NationalAssociationOfRealtors/IndoorAirQualitySensor/_T1.jpg

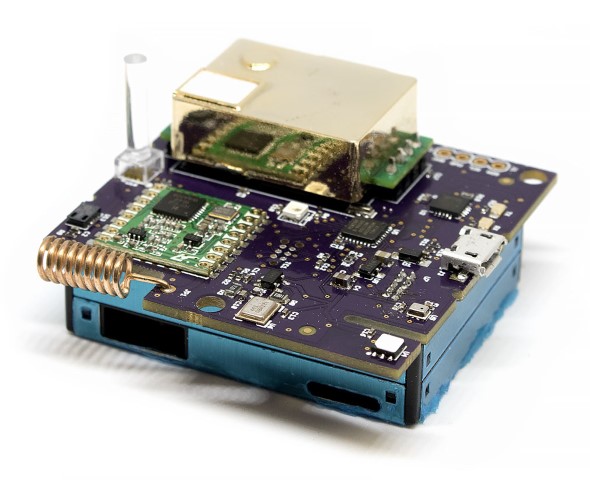
_T1.jpg
