NationalAssociationOfRealtors/IndoorAirQualitySensor/README.md

All development on the Indoor Air Quality sensor is now on its own repository [here](https://github.com/NationalAssociationOfRealtors/Touchstone).

This repo is left for historical records only.
