NationalAssociationOfRealtors/IndoorAirQualitySensor/_OSHPark_render_v056b.png

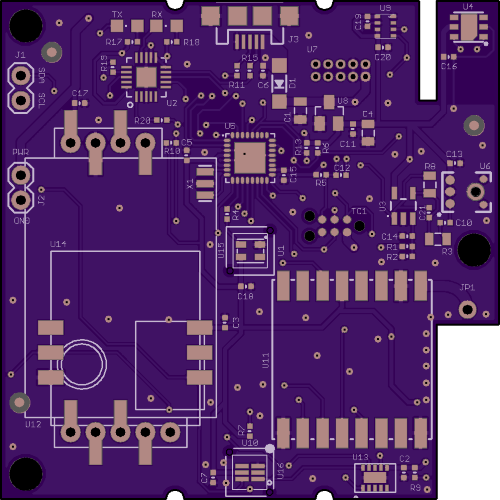
_OSHPark_render_v056b.png
