NationalAssociationOfRealtors/IndoorAirQualitySensor/enclosure/IAQ-Case-bottom.stl

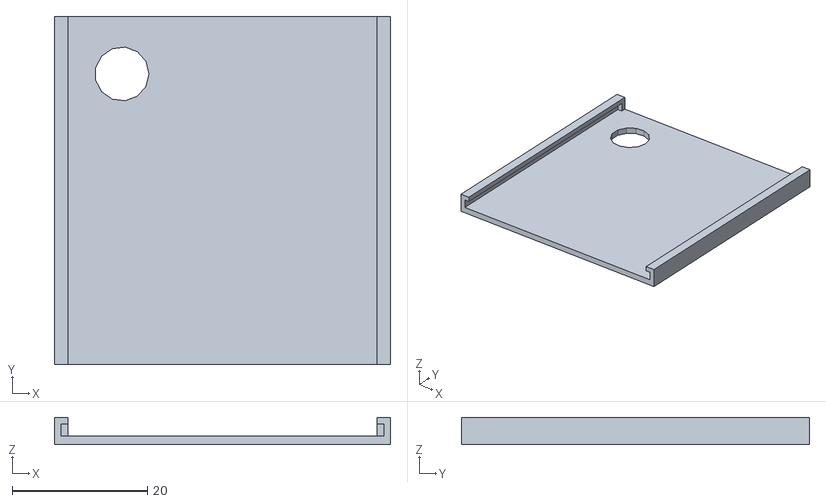
[picture p3: CAD file, 2016-09-28]
enclosure/IAQ-Case-bottom.stl
49.8 x 51.5 x 4.00
