NationalAssociationOfRealtors/IndoorAirQualitySensor/enclosure/includes/IAQ-Case.stl

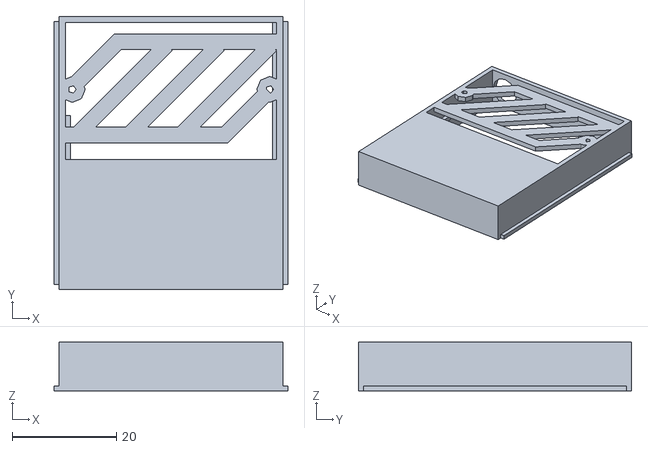
[picture p4: CAD file, 2016-09-28]
enclosure/includes/IAQ-Case.stl
44.9 x 52.4 x 9.40
