NationalAssociationOfRealtors/IndoorAirQualitySensor/enclosure/includes/IAQ-Case-bottom.stl

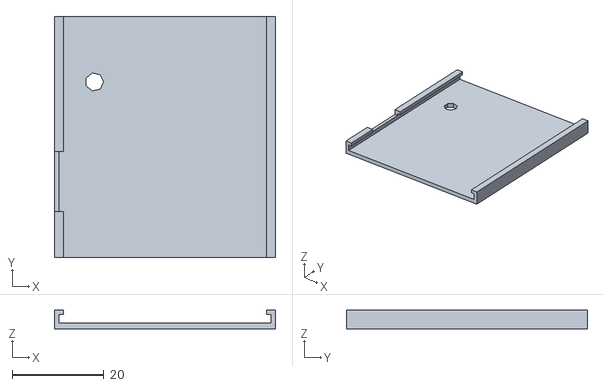
[picture p5: CAD file, 2016-09-28]
enclosure/includes/IAQ-Case-bottom.stl
48.1 x 52.4 x 4.10
