NationalAssociationOfRealtors/IndoorAirQualitySensor/IAQ-Case.scad

// IAQ Cover and Base v.0.01
// August 2016
// Initial Design to Protect Sensor Board IAQ Circuit Board Designed by Akram Ali
// CRT Labs / National Association of REALTORS
// https://crtlabs.org

////////////////////////////////////////////////
// Includes and Definitions
////////////////////////////////////////////////
use <Write.scad>
use <honeycomb.scad>
use <sensorlocations.scad>
top_cover_height = 3;
base_width = 47.5;
base_length = 40.5;
case_shell = 2;
spacer = 10;
font = "orbitron.dxf";

////////////////////////////////////////////////
// Honeycomb Settings
////////////////////////////////////////////////
// number of rows and columns, beware that some hexagonal cells are clipped
// at rectangular box boundaries, so the total number of cells will be
// smaller than rows * columns
rows          = 12;
columns       = 9;

// cell step is hole size between opposite hexagon walls plus inner wall thickness
cell_step     = 4.87;

// inner depth of the hexagonal boxes
hex_height        = 3;

// walls thickness
inner_walls   = .51;
outer_walls   = 2.65;

// this clearance should allow fitting of the lid over the bottom box
lid_clearance = 0.6;

// how far does the lid protrube inside the bottom box
lid_depth     = 5;

////////////////////////////////////////////////
// Modules 
/////////////////////////////////////////////////
module top_cover() {
  difference() {
      cube([base_length + 2 * case_shell, base_width + 2 * case_shell, top_cover_height + 2 * case_shell]);
      translate([case_shell, case_shell, 0])
        cube([base_length, base_width, top_cover_height + 2 *case_shell]);
   }
}

module bottom_cover() {
  translate([0, base_width + spacer, 0]) {
    difference() {
      cube([base_length + 2 * case_shell, base_width + 2 * case_shell, top_cover_height + 2 * case_shell]);
      translate([case_shell, case_shell, case_shell])
        cube([base_length, base_width, top_cover_height + case_shell]);
    }
  }
}


module cutouts(){
        microphone(); 
        reset_button();
        pin_outs();
        co_no2();
        light_intensity();
        pressure();
        temp_humid();
}
module add_text(){
  translate ([base_width +case_shell-7, case_shell, top_cover_height+2*case_shell])
    rotate([0,0,90])
      write("CRT Labs IAQ", font = font , h = 2);


  translate ([base_width +case_shell-7, base_length-10, top_cover_height + 2*case_shell])
   rotate([0,0,90])
     write("https://crtlabs.org", font = font, h = 1.5);
     
}

module main(){
    translate ([0,0,top_cover_height + 2* case_shell])
       rotate([180,0,0]){
            top_cover();
            translate([0,0, top_cover_height + case_shell])
            bottom_part(rows, columns, cell_step, inner_walls, outer_walls, hex_height);
       }
      
       translate([0,spacer,0]){
           bottom_part(rows, columns, cell_step, inner_walls, outer_walls, hex_height);
       }
}

main();
