NationalAssociationOfRealtors/IndoorAirQualitySensor/(list of files, cad)

Other CAD files:
enclosure/includes/case.dxf
