NationalAssociationOfRealtors/IndoorAirQualitySensor/(threads)

Thread 2 (2017-03-08):

IAQ Core sensor reading fails

Korcsog, 2017-03-08:
Hi!
I've got an IAQ core C sensor as in that project.
I'm using the same code as you in my project, but i could not read any values from the MEMS sensor, except FF values or B5 values. The wiring and the resistors are OK. I'm using an ESP8266 (Wemos D1 mini) as an MCU. Any idea?

Is the CCS811 sensor better than the IAQ Core?

AKstudios, 2017-03-13:
They have similar performance. How did you solder the IAQ core? It's not great with reflows.
Can't tell much without looking at the code, setup, etc.

Korcsog, 2017-03-24:
Hi!
Simply soldered some wires temporarily.
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

Here is the code which doesn't work:
```
#include "Wire.h"

#define iaqaddress 0x5A

uint16_t predict;
uint8_t statu;
int32_t resistance;
uint16_t tvoc;

void setup()
{
  Serial.begin(9600);
  Wire.begin();
}

void loop()
{
  readAllBytes();
  checkStatus();

  Serial.print("CO2:");
  Serial.print(predict);
  Serial.print(", Status:");
  Serial.print(statu, HEX);
  Serial.print(", Resistance:");
  Serial.print(resistance);
  Serial.print(", TVoC:");
  Serial.println(tvoc);

  delay(2000);

}
void readAllBytes()
{
  Wire.requestFrom(iaqaddress, 9);

  predict = (Wire.read()<< 8 | Wire.read());
  statu = Wire.read();
  resistance = (Wire.read()& 0x00)| (Wire.read()<<16)| (Wire.read()<<8| Wire.read());
  tvoc = (Wire.read()<<8 | Wire.read());
}
void checkStatus()
{
  if(statu == 0x10)
  {
    Serial.println("Warming up...");
  }
  else if(statu == 0x00)
  {
    Serial.println("Ready");
  }
  else if(statu == 0x01)
  {
    Serial.println("Busy");
  }
  else if(statu == 0x80)
  {
    Serial.println("Error");
  }
  else
  Serial.println("No Status, check module");
}

```
I'm totally re-wrote from scratch (using an i2c library) and works:

```
 #include "brzo_i2c.h"

uint8_t SDA_PIN = 4;
uint8_t SCL_PIN = 5;
uint8_t iaq_adr = 0x5A;

uint8_t buffer[10];

uint8_t error = 0;

uint16_t co2;
uint16_t tvoc;

void setup() {
  Serial.begin(115200);
  brzo_i2c_setup(SDA_PIN, SCL_PIN, 3000);
}

void loop() {
   brzo_i2c_start_transaction(iaq_adr, 100);
   brzo_i2c_read(buffer, 9, true);

   if (buffer[2] == 0x10 ){
       Serial.println("Warming up...");
   } else
   {

    co2 = buffer[0] * pow(2, 8) + buffer[1];
    tvoc = buffer[7] * pow(2, 8) + buffer[8];

    Serial.print("CO2 : \t"); Serial.print(co2);
    Serial.print("TVOC : \t"); Serial.println(tvoc);
   }

   /*
   Serial.print("Byte 1:\t"); Serial.println(buffer[0]);
   Serial.print("Byte 2:\t"); Serial.println(buffer[1]);
   Serial.print("Byte 3 (status) :\t"); Serial.println(buffer[2]);
   Serial.print("Byte 4:\t"); Serial.println(buffer[3]);
   Serial.print("Byte 5:\t"); Serial.println(buffer[4]);
   Serial.print("Byte 6:\t"); Serial.println(buffer[5]);
   Serial.print("Byte 7:\t"); Serial.println(buffer[6]);
   Serial.print("Byte 8:\t"); Serial.println(buffer[7]);
   Serial.print("Byte 9:\t"); Serial.println(buffer[7]);
   */

   error = brzo_i2c_end_transaction();

   if (error == 0) {
     //Serial.println("No i2c communication errors");
  }
  else {
    Serial.print("Brzo error : ");
    Serial.println(error);
  }
   delay(500);
}
```

Closed 2017-03-24.
