NationalAssociationOfRealtors/IndoorAirQualitySensor/hardware/v0.56/sensor_board_v0.56.brd

## EAGLE design hardware/v0.56/sensor_board_v0.56.brd (2017-07-17)

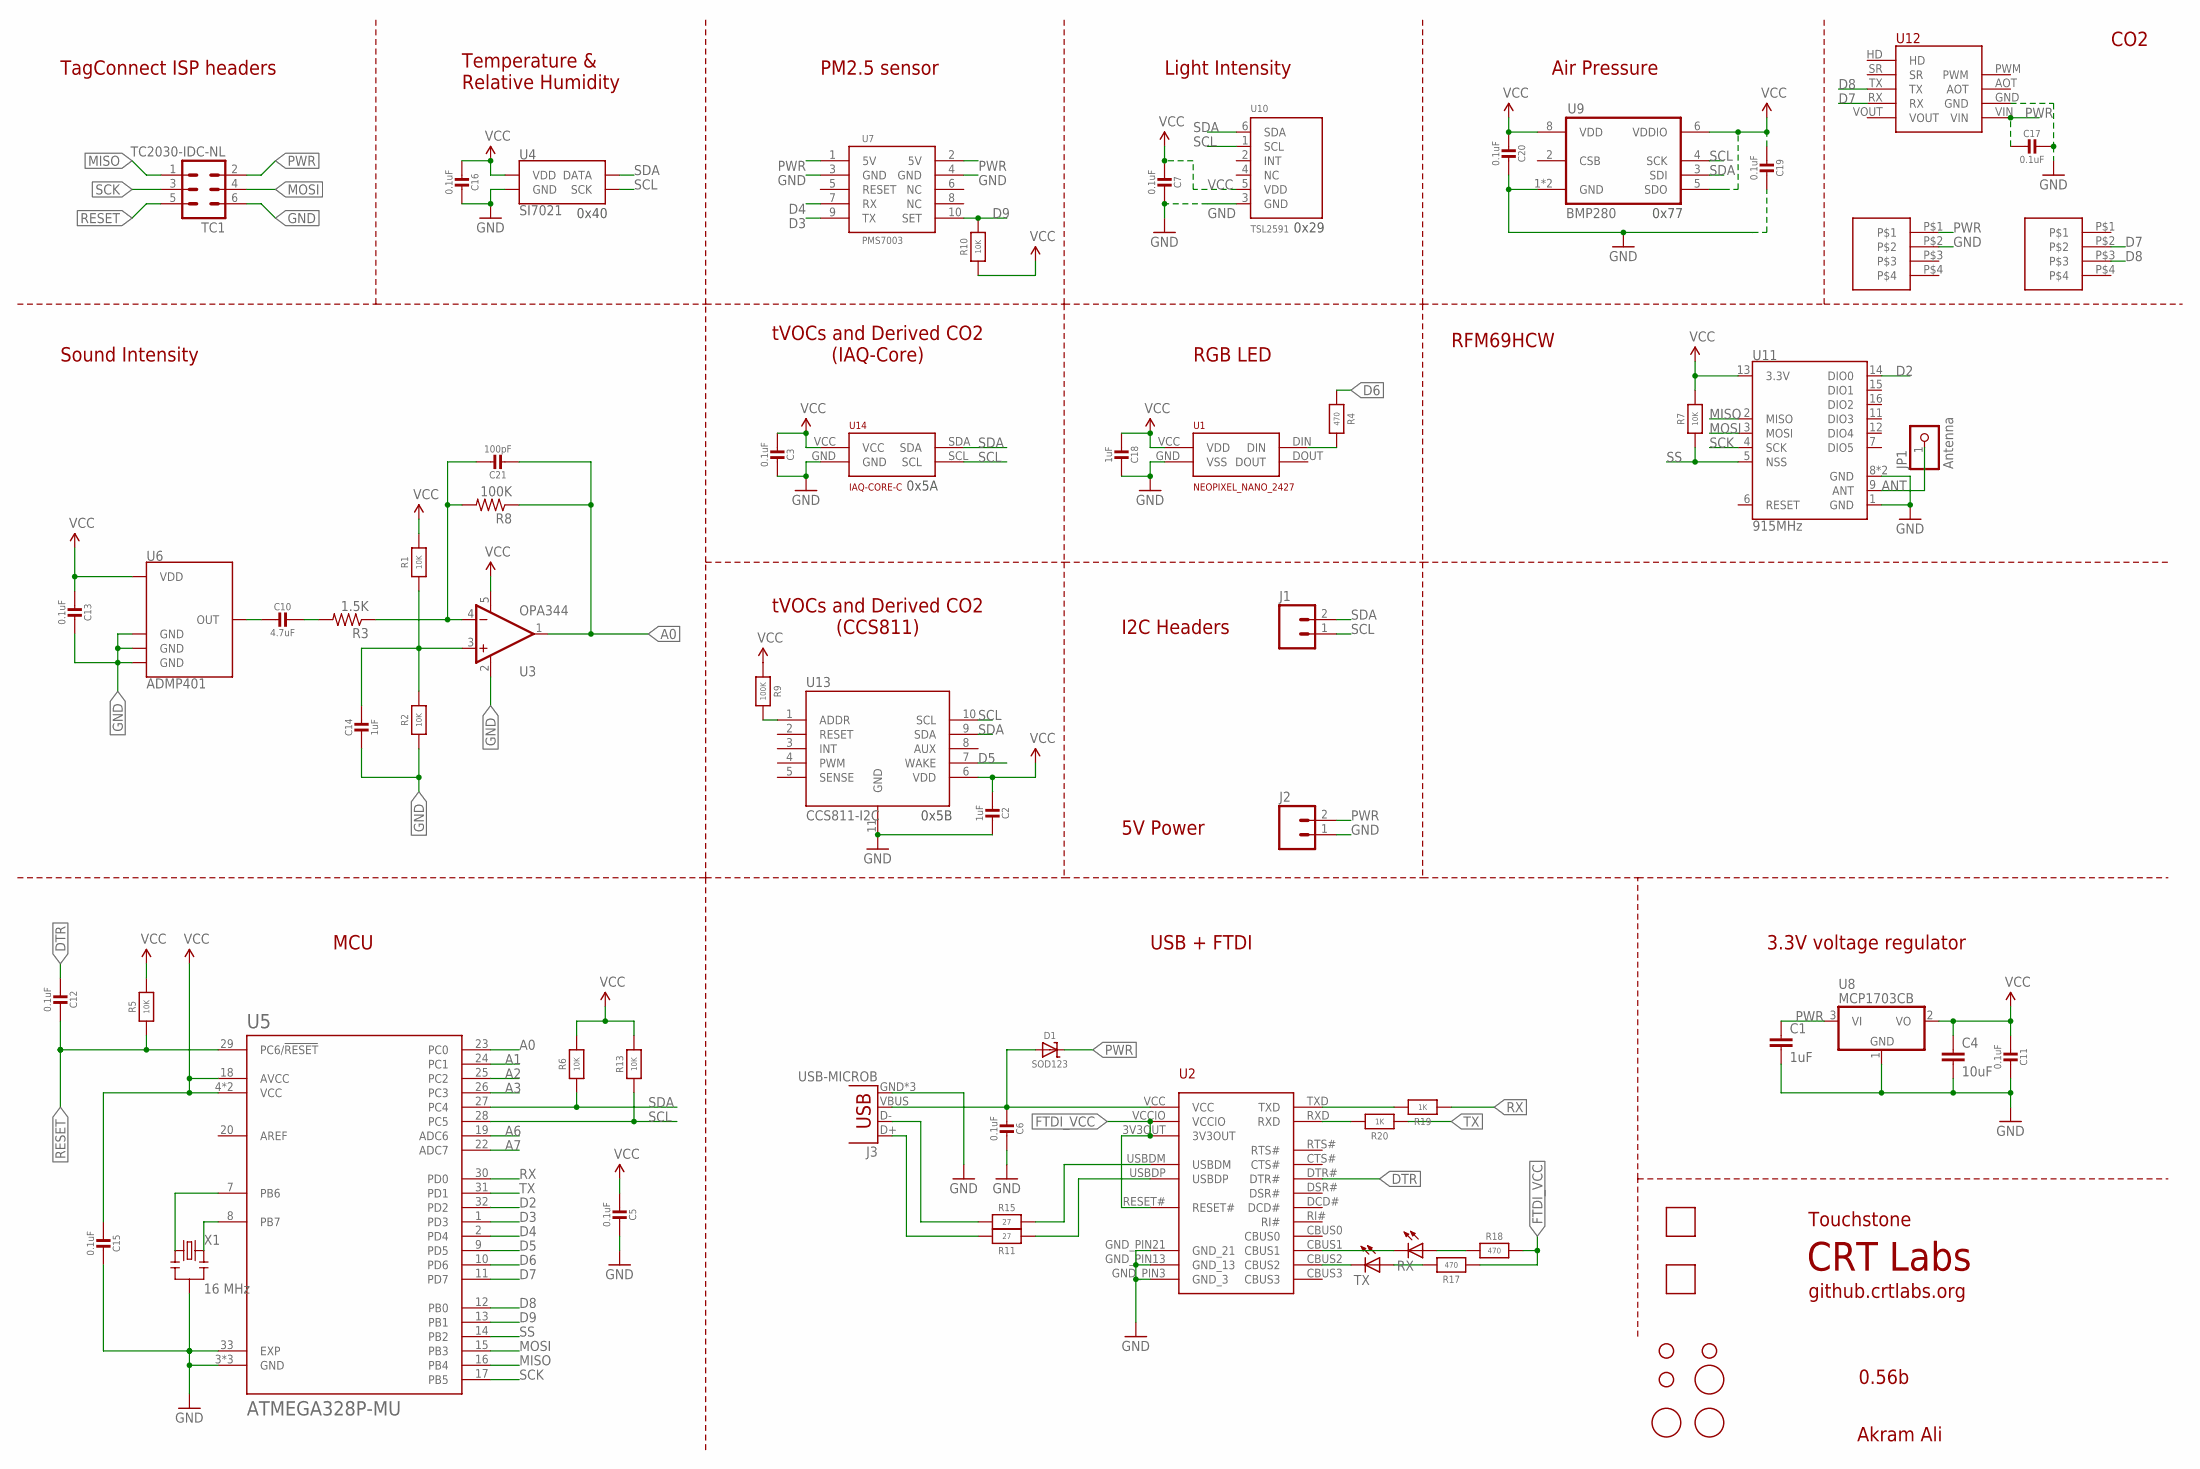
[picture p6: schematic sensor_board_v0.56.sch]

Parts:
C1: 1uF; 0805; MPN CC0805ZRY5V8BB105
C2, C14, C18: 1uF; MICROBUILDER__0402MP
C3, C5, C6, C7, C11, C12, C13, C15, C16, C17, C19, C20: 0.1uF; MICROBUILDER__0402MP
C4: 10uF; 0805; MPN CC0805KKX5R6BB106
C10: 4.7uF; MICROBUILDER__0402MP
C21: 100pF; MICROBUILDER__0402MP
D1: SOD123; MICROBUILDER_SOD-123
H1, H2, H3: STAND-OFF
J1, J2: M02PTH; 1X02
J3: USB-MICROB; MPN 47346-0001
JP1: Antenna; 1X01-CLEANBIG
R1, R2, R5, R6, R7, R10, R13: 10K; MICROBUILDER__0402MP
R3: 1.5K; 0805; MPN RC0805FR-071K5L
R4, R17, R18: 470; MICROBUILDER__0402MP
R8: 100K; 0805; MPN RC0805FR-07100KL
R9: 100K; MICROBUILDER__0402MP
R11, R15: 27; MICROBUILDER__0402MP
R19, R20: 1K; MICROBUILDER__0402MP
RX: LEDCHIPLED_0805; CHIPLED_0805; MPN LG R971-KN-1
TC1: TC2030-IDC-NL
TX: LEDCHIPLED_0805; CHIPLED_0805; MPN LG R971-KN-1
U1: NEOPIXEL_NANO_2427; SK6805-2427
U2: FT231XQ-R; FTDI_FT231XQ-R_PACKAGE
U3: OPA344; SOT23-5; MPN OPA344NA/3K
U4: SI7021; DFN-6-3X3-SI7021
U5: ATMEGA328P-MU; QFN50P500X500X100-33N
U6: ADMP401; MPN INMP401ACEZ-R7
U7: PMS7003; PMS7003_RECEPTACLE_1.27MM_2X5
U8: MCP1703CB; SOT23; MPN MCP1703T-2502E/CB
U9: BMP280; MPN BMP280
U10: TSL2591; DFN6_TAOS; MPN TSL25911FN
U11: 915MHz; RFM69HCW-XXXS2
U12: MH-Z19; MPN MH-z19
U13: CCS811-I2C; LGA
U14: IAQ-CORE-C
U15, U16: VLP-450-F
U$1, U$2, U$3: FIDUCIAL; FIDUCIAL_1MM
U$4, U$5: 0878980426; CONN_4POS_VERT_2.54_SMD
X1: 16 MHz; RESONATOR-SMD

Connections:
A0: C21.2, R8.1, U3.1 (OUT), U5.23 (PC0)
A1: U5.24 (PC1)
A2: U5.25 (PC2)
A3: U5.26 (PC3)
A6: U5.19 (ADC6)
A7: U5.22 (ADC7)
ANT: JP1.1, U11.9 (ANT)
D2: U5.32 (PD2), U11.14 (DIO0)
D3: U5.1 (PD3), U7.9 (TX)
D4: U5.2 (PD4), U7.7 (RX)
D5: U5.9 (PD5), U13.7 (WAKE)
D6: R4.1, U5.10 (PD6)
D7: U5.11 (PD7), U12.RX, U$5.P$2
D8: U5.12 (PB0), U12.TX, U$5.P$3
D9: R10.2, U5.13 (PB1), U7.10 (SET)
DTR: C12.2, U2.DTR#
FTDI_VCC: R17.1, R18.2, U2.3V3OUT, U2.RESET#, U2.VCCIO
GND: C1.2, C2.1, C3.1, C4.2, C5.1, C6.1, C7.1, C11.1, C13.1, C14.2, C15.1, C16.1, C17.1, C18.1, C19.1, C20.1, J2.1, J3.GND, J3.MT1 (GND), J3.MT2 (GND), R2.1, TC1.6, U1.GND (VSS), U2.GND_PIN3 (GND_3), U2.GND_PIN13 (GND_13), U2.GND_PIN21 (GND_21), U3.2 (V-), U4.GND, U5.3 (GND), U5.5 (GND), U5.21 (GND), U5.33 (EXP), U6.2 (GND), U6.4 (GND), U6.6 (GND), U7.3 (GND), U7.4 (GND), U8.1 (GND), U9.1 (GND), U9.7 (GND), U10.3 (GND), U11.1 (GND), U11.8 (GND), U11.10 (GND), U12.GND, U13.11 (GND), U14.GND, U$4.P$2, X1.2
MISO: TC1.1, U5.16 (PB4), U11.2 (MISO)
MOSI: TC1.4, U5.15 (PB3), U11.3 (MOSI)
unnamed: R4.2, U1.DIN
unnamed: R20.2, U2.RXD
unnamed: R19.2, U2.TXD
unnamed: U5.8 (PB7), X1.3
unnamed: U5.7 (PB6), X1.1
unnamed: C10.1, R3.2
unnamed: C21.1, R3.1, R8.2, U3.4 (-IN)
unnamed: C14.1, R1.1, R2.2, U3.3 (+IN)
unnamed: R9.2, U13.1 (ADDR)
unnamed: RX.C, U2.CBUS1
unnamed: TX.C, U2.CBUS2
unnamed: R15.2, U2.USBDM
unnamed: R11.1, U2.USBDP
unnamed: R18.1, RX.A
unnamed: R17.2, TX.A
unnamed: J3.D-, R15.1
unnamed: J3.D+, R11.2
OUT: C10.2, U6.1 (OUT)
PWR: C1.1, C17.2, D1.C, J2.2, TC1.2, U7.1 (5V), U7.2 (5V), U8.3 (VI), U12.VIN, U$4.P$1
RESET: C12.1, R5.1, TC1.5, U5.29 (PC6/!RESET)
RX: R19.1, U5.30 (PD0)
SCK: TC1.3, U5.17 (PB5), U11.4 (SCK)
SCL: J1.1, R13.1, U4.SCK, U5.28 (PC5), U9.4 (SCK), U10.1 (SCL), U13.10 (SCL), U14.SCL
SDA: J1.2, R6.1, U4.DATA, U5.27 (PC4), U9.3 (SDI), U10.6 (SDA), U13.9 (SDA), U14.SDA
SS: R7.1, U5.14 (PB2), U11.5 (NSS)
TX: R20.1, U5.31 (PD1)
VBUS: C6.2, D1.A, J3.VBUS, U2.VCC
VCC: C2.2, C3.2, C4.1, C5.2, C7.2, C11.2, C13.2, C15.2, C16.2, C18.2, C19.2, C20.2, R1.2, R5.2, R6.2, R7.2, R9.1, R10.1, R13.2, U1.VCC (VDD), U3.5 (V+), U4.VDD, U5.4 (VCC), U5.6 (VCC), U5.18 (AVCC), U6.5 (VDD), U8.2 (VO), U9.5 (SDO), U9.6 (VDDIO), U9.8 (VDD), U10.5 (VDD), U11.13 (3.3V), U13.6 (VDD), U14.VCC

Notes on the sheet:
Light Intensity
tVOCs and Derived CO2 (IAQ-Core)
Air Pressure
Sound Intensity
Temperature & Relative Humidity
TagConnect ISP headers
3.3V voltage regulator
CRT Labs
Touchstone
Akram Ali
USB + FTDI
0x5A
0x77
0.56b
github.crtlabs.org
0x29
RGB LED
I2C Headers
PM2.5 sensor
RFM69HCW
MCU
CO2
tVOCs and Derived CO2 (CCS811)
5V Power
0x5B
0x40

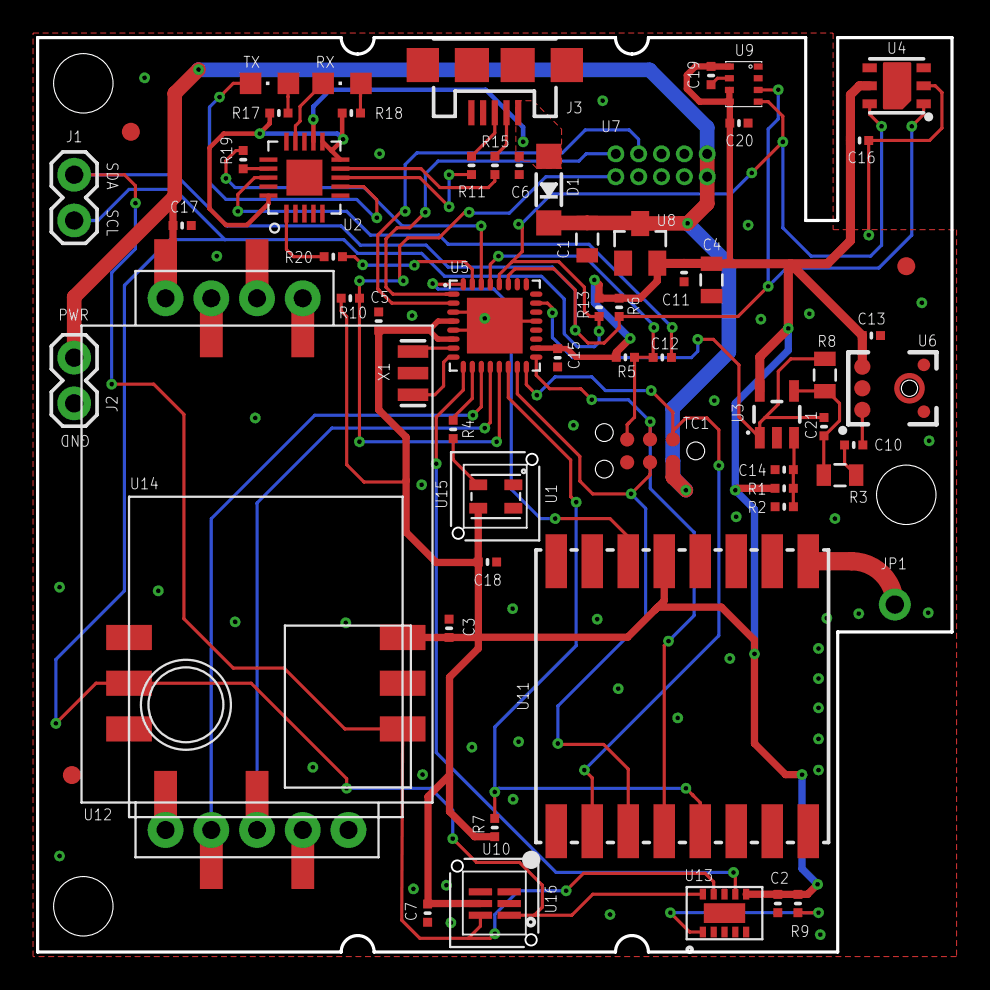
[picture p7: board sensor_board_v0.56.brd from above]

Board: 2 copper layers, 50.8 x 50.8 mm, 69 parts (1 on the bottom side), 43 nets.
