NationalAssociationOfRealtors/IndoorAirQualitySensor/hardware/Previous versions/v0.52/sensor_board_v0.52.brd

## EAGLE design hardware/Previous versions/v0.52/sensor_board_v0.52.brd (2017-02-21, an earlier design)

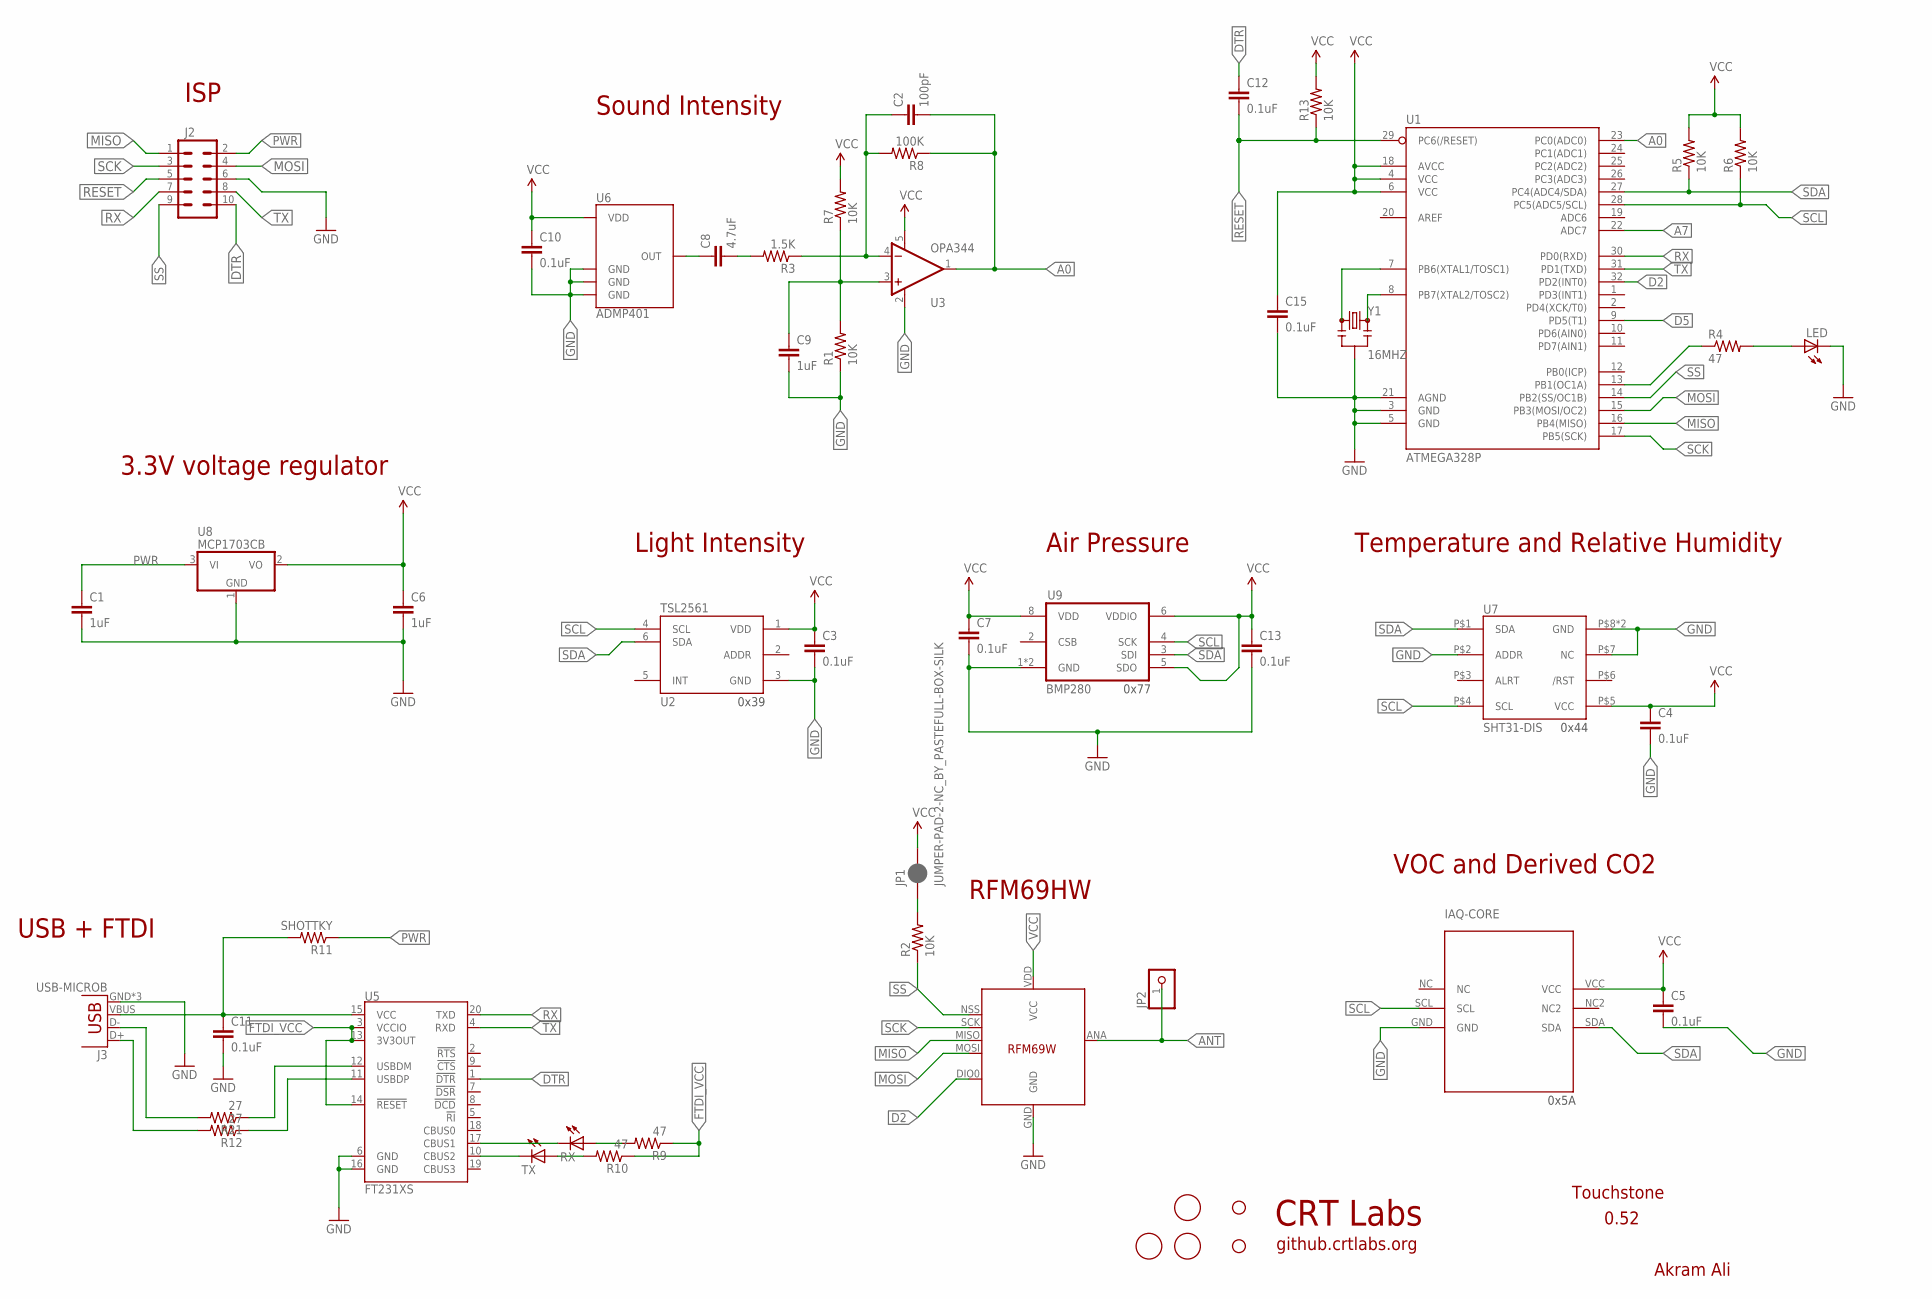
[picture p8: schematic sensor_board_v0.52.sch]

Parts:
C1, C6, C9: 1uF; 0805
C2: 100pF; 0805
C3, C4, C5, C7, C10, C11, C12, C13, C15: 0.1uF; 0805
C8: 4.7uF; 0805
H1, H2: STAND-OFF
IAQ-CORE: IAQ-CORE; MPN IAQ CORE
J2: M05X2PTH; AVR_ICSP
J3: USB-MICROB
JP1: JUMPER-PAD-2-NC_BY_PASTEFULL-BOX-SILK; PAD-JUMPER-2-NC_BY_PASTE_YES_SILK_FULL_BOX
JP2: PINHD-1X1; 1X01
LED: LEDCHIPLED_0805; CHIPLED_0805
R1, R2, R5, R6, R7, R13: 10K; 0805
R3: 1.5K; 0805
R4, R9, R10: 47; 0805
R8: 100K; 0805
R11: SHOTTKY; 0805
R12, R21: 27; 0805
RX: LEDCHIPLED_0805; CHIPLED_0805
TX: LEDCHIPLED_0805; CHIPLED_0805
U1: ATMEGA328P; TQFP32-08; MPN ATMEGA328PB-AU
U2: TSL2561; FN-6; MOUSER# 856-TSL2561T; DIGIKEY# TSL2561-FNCT-ND
U3: OPA344; SOT23-5
U4: RFM69HW; LOWPOWERLAB_RFM69W-MINPADS
U5: FT231XS; SSOP20_L
U6: ADMP401
U7: SHT31-DIS; SHT3X; MPN SHT31-DIS-B
U8: MCP1703CB; SOT23; MPN MCP1703T-2502E/CB
U9: BMP280
U$1, U$2, U$3: FIDUCIAL; FIDUCIAL_1MM
Y1: 16MHZ; RESONATOR-SMD

Connections:
A0: C2.2, R8.1, U1.23 (PC0(ADC0)), U3.1 (OUT)
A7: U1.22 (ADC7)
ANT: JP2.1, U4.ANA (ANT)
D2: U1.32 (PD2(INT0)), U4.DIO0
D5: U1.9 (PD5(T1))
DTR: C12.1, J2.10, U5.1 (!DTR)
FTDI_VCC: R9.1, R10.1, U5.3 (VCCIO), U5.13 (3V3OUT), U5.14 (!RESET)
GND: C1.2, C3.2, C4.2, C5.2, C6.2, C7.2, C9.2, C10.2, C11.2, C13.2, C15.2, IAQ-CORE.GND, J2.6, J3.GND, J3.MT1 (GND), J3.MT2 (GND), LED.C, R1.1, U1.3 (GND), U1.5 (GND), U1.21 (AGND), U2.3 (GND), U3.2 (V-), U4.GND, U5.6 (GND), U5.16 (GND), U6.2 (GND), U6.4 (GND), U6.6 (GND), U7.P$2 (ADDR), U7.P$7 (NC), U7.P$8 (GND), U7.PAD (GND), U8.1 (GND), U9.1 (GND), U9.7 (GND), Y1.2
MISO: J2.1, U1.16 (PB4(MISO)), U4.MISO
MOSI: J2.4, U1.15 (PB3(MOSI/OC2)), U4.MOSI
unnamed: JP1.1, R2.2
unnamed: R4.1, U1.13 (PB1(OC1A))
unnamed: LED.A, R4.2
unnamed: U1.8 (PB7(XTAL2/TOSC2)), Y1.3
unnamed: U1.7 (PB6(XTAL1/TOSC1)), Y1.1
unnamed: C8.2, R3.2
unnamed: C2.1, R3.1, R8.2, U3.4 (-IN)
unnamed: C9.1, R1.2, R7.1, U3.3 (+IN)
unnamed: RX.C, U5.17 (CBUS1)
unnamed: TX.C, U5.10 (CBUS2)
unnamed: R21.1, U5.12 (USBDM)
unnamed: R12.1, U5.11 (USBDP)
unnamed: R9.2, RX.A
unnamed: R10.2, TX.A
unnamed: J3.D-, R21.2
unnamed: J3.D+, R12.2
OUT: C8.1, U6.1 (OUT)
PWR: C1.1, J2.2, R11.1, U8.3 (VI)
RESET: C12.2, J2.5, R13.1, U1.29 (PC6(/RESET))
RX: J2.7, U1.30 (PD0(RXD)), U5.20 (TXD)
SCK: J2.3, U1.17 (PB5(SCK)), U4.SCK
SCL: IAQ-CORE.SCL, R6.1, U1.28 (PC5(ADC5/SCL)), U2.4 (SCL), U7.P$4 (SCL), U9.4 (SCK)
SDA: IAQ-CORE.SDA, R5.1, U1.27 (PC4(ADC4/SDA)), U2.6 (SDA), U7.P$1 (SDA), U9.3 (SDI)
SS: J2.9, R2.1, U1.14 (PB2(SS/OC1B)), U4.NSS (SEL)
TX: J2.8, U1.31 (PD1(TXD)), U5.4 (RXD)
VBUS: C11.1, J3.VBUS, R11.2, U5.15 (VCC)
VCC: C3.1, C4.1, C5.1, C6.1, C7.1, C10.1, C13.1, C15.1, IAQ-CORE.VCC, JP1.2, R5.2, R6.2, R7.2, R13.2, U1.4 (VCC), U1.6 (VCC), U1.18 (AVCC), U2.1 (VDD), U3.5 (V+), U4.VDD (VCC), U6.5 (VDD), U7.P$5 (VCC), U8.2 (VO), U9.5 (SDO), U9.6 (VDDIO), U9.8 (VDD)

Notes on the sheet:
Light Intensity
VOC and Derived CO2
Air Pressure
Sound Intensity
Temperature and Relative Humidity
ISP
3.3V voltage regulator
CRT Labs
Touchstone
Akram Ali
RFM69HW
USB + FTDI
0x39
0x5A
0x44
0x77
0.52
github.crtlabs.org

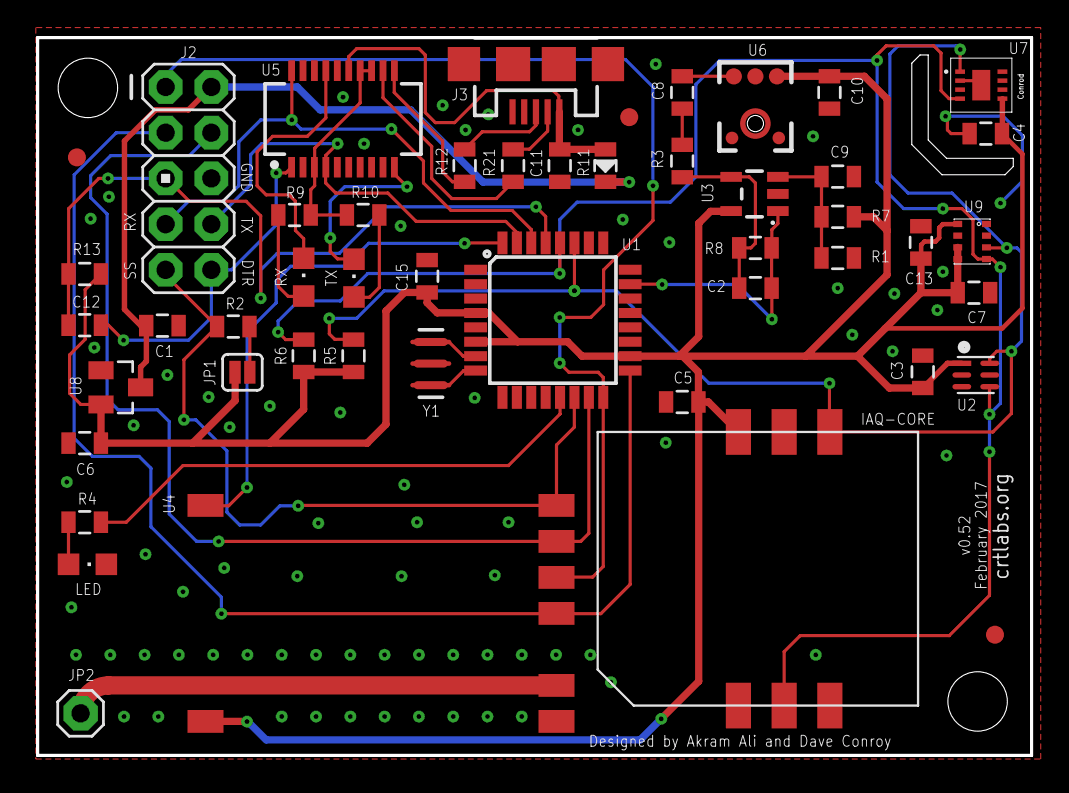
[picture p9: board sensor_board_v0.52.brd from above]

Board: 2 copper layers, 55.2 x 39.9 mm, 51 parts (0 on the bottom side), 35 nets.
