NationalAssociationOfRealtors/IndoorAirQualitySensor/(commit log)

2016-07-27 Eagle files for sensor board
    [sensor node3.brd, sensor node3.sch]
2016-07-28 Replaced 5V stepup with reg
    Replaced NCP1402 with MCP1703 (for MICS 4514 gas sensor)
    [sensor node4.brd, sensor node4.sch]
2016-08-10 Adding Case Design and STL
    [IAQ-Case.scad, IAQ-Case.stl, Write.scad, orbitron.dxf, sensor node4.brd]
2016-08-10 removing duplicate code
    [IAQ-Case.scad]
2016-08-11 adding honeycomb airflow
    [IAQ-Case.scad, IAQ-Case.stl, honeycomb.scad, qr.scad, sensorlocations.scad]
2016-08-11 code cleanup
    [IAQ-Case.scad, IAQ-Case.stl]
2016-08-11 added rounded corners, dir struxture
    [IAQ-Case.scad, IAQ-Case.stl, honeycomb.scad, orbitron.dxf, qr.scad, roundedcube.scad, sensorlocations.scad, writetext.scad]
2016-08-11 adjusted cell step
    [IAQ-Case.stl]
2016-08-11 flipping for easier print
    [IAQ-Case.scad, IAQ-Case.stl]
2016-08-11 added slot for pinouts
    [IAQ-Case.scad, IAQ-Case.stl]
2016-08-11 adding new stl
    [IAQ-Case.stl]
2016-08-12 logo text on side of case
    [IAQ-Case.scad, IAQ-Case.stl]
2016-08-16 adding slide cover
    [IAQ-Case-top.stl, IAQ-Case-top_bottom.stl, IAQ-Case.scad, IAQ-Case.stl, IAQ-Case_bottom.stl, dimensions.scad, triangles.scad]
2016-08-16 added url to bottom cover
    [IAQ-Case-top.stl, IAQ-Case.scad, IAQ-Case.stl, IAQ-Case_bottom.stl]
2016-08-25 added labels to board and ftdi mapping instructions
    [sensor node4.brd]
2016-09-06 Sensor board v0.2 Arduino test code
    Read all data in serial monitor.
    Untested: TSL2561
    Untested: MAX4466
2016-09-06 Updated to v0.03
    [sensor_node_v0.01.brd, sensor_node_v0.01.sch, sensor_node_v0.02.brd, sensor_node_v0.02.sch, sensor_node_v0.03.brd, sensor_node_v0.03.sch]
2016-09-06 Replaced mic
    [sensor_node_v0.03.brd, sensor_node_v0.03.sch]
2016-09-07 Added RFM69 pads, FTDI chip, USB-microB, bug fixes
    [sensor_node_v0.03.brd, sensor_node_v0.03.sch]
2016-09-07 GND0 plane fix
    [sensor_node_v0.03.brd]
2016-09-07 first commit of radio board
    [radio_board_v0.1.brd, radio_board_v0.1.sch]
2016-09-07 Changed font size of labels
    [sensor_node_v0.03.brd, sensor_node_v0.03.sch]
2016-09-08 Updating version numbers
    [IAQ-Case-top.stl, IAQ-Case.scad, IAQ-Case.stl, IAQ-Case_bottom.stl, radio_board_v0.1.brd, sensor_node_v0.1.brd, sensor_node_v0.1.sch, sensor_node_v0.2.brd]
2016-09-08 directory organization
    [radio_board_v0.1.brd, radio_board_v0.1.sch, sensor_board_v0.1.brd, sensor_board_v0.1.sch, sensor_board_v0.2.brd, sensor_board_v0.2.sch, sensor_board_v0.3.brd, sensor_board_v0.3.sch]
2016-09-08 adding professional shots and updating readme
    [IAQ-Case.scad]
2016-09-08 adding tool to read sensor data for initial testing
2016-09-08 prepping for hardware version 3.0
    [IAQ-Case-top.stl, IAQ-Case-top_bottom.stl, IAQ-Case.scad, IAQ-Case.stl, IAQ-Case_bottom.stl, dimensions.scad, honeycomb.scad, orbitron.dxf]
2016-09-08 modifying v3 enclosure and fixing typo on sensor board v3 schematic
    [IAQ-Case.scad, dimensions.scad, honeycomb.scad, sensor_board_v0.3.sch, sensorlocations.scad]
2016-09-08 Fixed preheat pins for gas sensor
    [SensorBoard.ino]
2016-09-08 Moved hidden labels to tNames layer
    [sensor_board_v0.3.brd]
2016-09-08 Moved labels to _tsilk layer (121)
    [sensor_board_v0.3.brd, sensor_board_v0.3.sch]
2016-09-08 Added PDF schematic
2016-09-08 Updated PCB render
2016-09-08 Adjusted some traces
    [sensor_board_v0.3.brd, sensor_board_v0.3.sch]
2016-09-09 Added SMA connector for antenna
    [sensor_board_v0.4.brd, sensor_board_v0.4.sch]
2016-09-09 Minor touches
    [sensor_board_v0.4.brd, sensor_board_v0.4.sch]
2016-09-09 Minor touches v2
    [sensor_board_v0.4.brd]
2016-09-09 Removed 'label' from SMA connector
    [sensor_board_v0.4.brd, sensor_board_v0.4.sch]
2016-09-09 Update README.md
    Added sensor model numbers
2016-09-10 syntax on scad
    [IAQ-Case.scad]
2016-09-14 Created v0.5
    [sensor_board_v0.5.brd, sensor_board_v0.5.sch]
2016-09-14 Removed NPN transistor
    connected everything to common GND
    [sensor_board_v0.5.brd, sensor_board_v0.5.sch]
2016-09-14 Increased thickness of power lines to 16
    [sensor_board_v0.5.brd, sensor_board_v0.5.sch]
2016-09-14 Added I2C addresses in schematic
    [sensor_board_v0.5.brd, sensor_board_v0.5.sch]
2016-09-14 Added decoupling cap for ATmega328P
    0.1uF
    [sensor_board_v0.5.brd, sensor_board_v0.5.sch]
2016-09-14 Rearranged status LED
    and decoupling cap
    [sensor_board_v0.5.brd]
2016-09-14 Moved decoupling caps closer to ICs
    [sensor_board_v0.5.brd, sensor_board_v0.5.sch]
2016-09-14 Added extra GND vias
    [sensor_board_v0.5.brd]
2016-09-14 Adjusted some traces around MCU
    [sensor_board_v0.5.brd]
2016-09-14 Added v0.5 PDF schematic
2016-09-14 Adjusted silk screen
    [sensor_board_v0.5.brd]
2016-09-15 Made the GND plane more consistent
    [sensor_board_v0.5.brd]
2016-09-15 Connected GND plane
    [sensor_board_v0.5.brd]
2016-09-15 Added PiHAT
    [PiHAT.brd, PiHAT.sch]
2016-09-15 Bulk copy/paste schematic
    [PiHAT.brd, PiHAT.sch]
2016-09-15 Removed FTDI, RFM69, USB
    [PiHAT.brd, PiHAT.sch]
2016-09-15 started mapping sensors for pi hat
    [PiHAT.brd, PiHAT.sch]
2016-09-16 Minor touch up of some traces
    near TSL2561 and SHT31
    [sensor_board_v0.5.brd]
2016-09-16 All traces routed - v0.1
    [PiHAT.brd, PiHAT.sch]
2016-09-16 Verrrrrry minor adjustments
    ¯\_(ツ)_/¯
2016-09-19 sensor board BOM
    [sensor_board_BOM.csv]
2016-09-19 Fixed several traces
    [PiHAT.brd, PiHAT.sch]
2016-09-19 Added labels
    [PiHAT.brd]
2016-09-19 Updated silkscreen
    [PiHAT.brd, PiHAT.sch]
2016-09-19 Added CRT Labs logo, gerber files
    [PiHAT.brd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]
2016-09-19 Adjusted schematic
    [PiHAT.sch]
2016-09-27 Added sensor board node firmware
2016-09-27 Changed WDT prescaler to 4 seconds
    Reduced delay on breath LED
2016-09-28 Moved Trace on PiAQ, v4 of enclosure
    [IAQ-Case-bottom.stl, IAQ-Case.scad, IAQ-Case.stl, PiHAT.brd, case.dxf, honeycomb.scad, orbitron.dxf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]
2016-09-29 updating bom and iaq-case v4
    [IAQ-Case.scad, IAQ-Case.stl, sensor_board_BOM.csv]
2016-10-03 v0.6 - Major design update
    - Added CCS811 gas sensor (replaced IAQ core)
    - Added thermal isolation for all sensors
    - Rearranged all components to accommodate for thermal isolation
    - Ripped up all traces and rerouted them based on new arrangement
    - Temporarily removed ADMP401 mic + opamp (previous design was
    incorrect; requires envelop follower circuit for sound intensity
    measurements from analog signals)
    - Removed SS pin of radio from the ISP header - no longer necessary,
    since radio is on board.
    [sensor_board_v0.6.brd, sensor_board_v0.6.sch]
2016-10-05 started adding links to schematics and data sheets
2016-10-05 adding bom values
    [PiHAT.brd, PiHAT.sch]
2016-10-05 added link to board
2016-10-05 continuing to add BOM materials
    [PiHAT.brd, PiHAT.sch]
2016-10-05 Updating BOM
    [PiHAT.brd, PiHAT.sch, PiHAT_BOM.csv, sensor_board_BOM.csv]
2016-10-05 removing chars from BOM
    [PiHAT_BOM.csv]
2016-10-05 updating descriptions on bom
    [PiHAT.brd, PiHAT.sch, PiHAT_BOM.csv]
2016-10-05 Added 5x2 header attribute
    Digikey part number
    [PiHAT.brd, PiHAT.sch]
2016-10-05 Updated BOM
    Digikey part number for MOSFET
    [PiHAT.brd, PiHAT.sch]
2016-10-05 updating mom and shopping cart links
    [PiHAT_BOM.csv]
2016-10-06 Moved files to separate folder
    v0.1
    [PiHAT.brd, PiHAT.sch, PiHAT_BOM.csv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]
2016-10-06 adding head to faq page
    [sensor_board_BOM.csv]
2016-10-06 Updated PiAQ HAT to v0.2
    - Added LEDs on GPIO 05, 26
    - Replaced IAQ Core with CCS811
    - Added more thermal isolation and rerouted traces
    - Minor silkscreen adjustments
    [PiHAT.brd, PiHAT.sch, PiHAT_BOM.csv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]
2016-10-06 Minor fixes to sensor board v0.6
    [PiHAT.brd, PiHAT.sch, sensor_board_v0.6.brd, sensor_board_v0.6.sch]
2016-10-06 Silkscreen adjustments
    [sensor_board_v0.6.brd]
2016-10-06 Added environmental parameters to silkscreen
    [sensor_board_v0.6.brd]
2016-10-06 Minor trace fix
    [sensor_board_v0.6.brd]
2016-10-06 Trace adjustments
    [sensor_board_v0.6.brd]
2016-10-06 Removed GND silkscreen from bottom
    [sensor_board_v0.6.brd]
2016-10-06 I2C pullups silkscreen
    [sensor_board_v0.6.brd]
2016-10-06 Fixed layers
    [sensor_board_v0.6.brd]
2016-10-06 Added FTDI headers to Pi HAT, separated ISP headers
    [PiHAT.brd, PiHAT.sch]
2016-10-06 Adjusted a trace in sensor board
    [sensor_board_v0.6.brd]
2016-10-06 Power trace adjustment
    [PiHAT.brd]
2016-10-06 v0.7 - Added mounting holes to the board
    - Dimension change
    - curved edges
    [sensor_board_v0.7.brd, sensor_board_v0.7.sch]
2016-10-06 v0.7 - design changes
    - Adjusted I2C traces
    - Increased thermal isolation to fit new board dimensions
    - Moved SMA antenna pads to the top
    - Adjusted MiCS 4514 sensor position
    - Silkscreen adjustments
    [sensor_board_v0.7.brd]
2016-10-06 Adjusted microUSB port towards the edge
    [sensor_board_v0.7.brd]
2016-10-06 cap trace adjustment
    [sensor_board_v0.7.brd]
2016-10-06 Added loads of GND vias because ¯\_(ツ)_/¯
    [sensor_board_v0.7.brd]
2016-10-07 v2 gerber files
    [PiHAT.drills.xln]
2016-10-07 adding MPN to v2 schematics
    [PiHAT.brd, PiHAT.sch, PiHAT_BOM.csv]
2016-10-07 Sensor Node Photo
2016-10-07 updating sch for cleaner bom
    [PiHAT.brd, PiHAT.sch, PiHAT_BOM.csv]
2016-10-07 adding details to aid in fabrication
    [PiHAT.brd, PiHAT.sch, PiHAT_BOM.csv]
2016-10-11 Renamed file names for each version
    [PiHAT_v0.1.brd, PiHAT_v0.1.sch, PiHAT_v0.2.brd, PiHAT_v0.2.sch]
2016-10-18 v0.8 - Replaced MPL3115A2 with BMP280
    BMP280 is lower power and more accurate
    [sensor_board_v0.8.brd, sensor_board_v0.8.sch]
2016-10-18 separating piaq to its own repo
    more information http://piaq.io
    [PiHAT_BOM.csv, PiHAT_v0.1.brd, PiHAT_v0.1.sch, PiHAT_v0.2.brd, PiHAT_v0.2.sch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]
2016-10-22 Added traces for WAKE and INT pin
    CCS811 requires WAKE pin to be triggered before every communication. INT
    can be useful in the future for lower power or threshold alerts.
    [sensor_board_v0.8.brd, sensor_board_v0.8.sch]
2016-10-22 Replaced ATmega328P TQFP with QFN/MLF Package
    [sensor_board_v0.8.brd, sensor_board_v0.8.sch]
2016-10-22 Updated CCS811 lbr
    slightly smaller pads
    [sensor_board_v0.8.brd, sensor_board_v0.8.sch]
2016-10-22 Updated CCS811 lbr
    [sensor_board_v0.8.brd, sensor_board_v0.8.sch]
2016-10-23 Replaced FT231X SSOP with QFN package
    New part number: FT231XQ-R
    Adjusted several traces for the new package
    [sensor_board_v0.8.brd, sensor_board_v0.8.sch]
2016-10-23 Adjusted silkscreen
    [sensor_board_v0.8.brd]
2016-10-23 Silkscreen adjustments
    Diode direction
    [sensor_board_v0.8.brd]
2016-10-23 Adjusted distance between MISO and MOSI vias
    [sensor_board_v0.8.brd]
2016-10-23 v0.9 - Major update
    - Removed MiCS4514
    - Added 3SP_CO Spec Sensor
    - Added potentiostat circuitry (LMP91000 and VREF) for interfacing with
    electrochemical sensor
    - Removed mounting holes
    - Various trace adjustments
    [sensor_board_v0.9.brd, sensor_board_v0.9.sch]
2016-10-23 Minor component adjustments
    [sensor_board_v0.9.brd]
2016-10-23 Moved silkscreen values to layer 121
    [sensor_board_v0.9.brd]
2016-10-25 Rearranged several compoents around LMP91000
    Rerouted several traces, other touch ups
    [sensor_board_v0.9.brd]
2016-11-28 began cleanup of repository in preparation of release
    [IAQ-Case-bottom.stl, IAQ-Case.scad, IAQ-Case.stl, case.dxf, dimensions.scad, honeycomb.scad, orbitron.dxf, radio_board_v0.1.brd]
2016-11-28 reading hardware and enclosure files for version 5
    [IAQ-Case-bottom.stl, IAQ-Case.stl, case.dxf, sensor_board_BOM.csv, sensor_board_v0.5.brd, sensor_board_v0.5.sch]
2017-01-24 v0.51 - design update
    - Removed MICS sensor - was getting too hot and throwing temp sensor off. Also didn't give any sensible readings
    - Relocated SHT31 sensor to edge of board and added thermal cutouts to allow more accurate readings
    - Adjusted some components and rerouted traces
    - Removed reset button (not necessary anymore)
    - Adjusted silkscreen
    [sensor_board_v0.51.brd, sensor_board_v0.51.sch]
2017-01-24 Adjusted one via to align with the 'o' of 'Board'
    because ¯\_(ツ)_/¯
    [sensor_board_v0.51.brd]
2017-01-24 Gerber files added
    For https://www.seeedstudio.com/fusion_pcb.html
2017-01-30 Added code to calculate uncalibrated SPL readings from mic
    function to determine SPL from ADC readings. May need a higher
    resolution ADC, possibly with higher sample rate to allow FFT
    calculations later on. (Maybe an ARM chip)
2017-02-17 v0.52 - major design update
    - Added mounting holes
    - Rearranged every single component for new board dimensions
    - Temporarily removed SMA edge mounted connector
    - RFM69 radio is now munted on top
    - Made ground pour more even + extra GND vias for proper stitching
    [sensor_board_BOM.csv, sensor_board_v0.5.brd, sensor_board_v0.5.sch, sensor_board_v0.51.brd, sensor_board_v0.51.sch, sensor_board_v0.52.brd, sensor_board_v0.52.sch]
2017-02-21 Added fiducial markers on PCB
    [sensor_board_v0.52.brd, sensor_board_v0.52.sch]
2017-02-21 Some trace adjustments
    [sensor_board_v0.52.brd]
2017-02-27 v0.53 added
    - Replaced TSL2561 with TSL2591 (former was approaching end of life)
    [sensor_board_v0.53.brd, sensor_board_v0.53.sch]
2017-03-01 Update - Features added
    - Replaced regular LED with RGB LED (NeoPixel from Adafruit)
    - Adjusted overall dimensions to give slightly higher tolerance for mounting holes
    - I2C pins broken out to headers
    - Two digital pins broken out (for software serial)
    - Extra power pins broken out (for powering external devices or connecting ground)
    [sensor_board_v0.53.brd, sensor_board_v0.53.sch]
2017-03-01 Trace adjustments
    Moved the radio and IAQ Core a bit to the left to allow more space for headers
    [sensor_board_v0.53.brd, sensor_board_v0.53.sch]
2017-03-01 BOM update - added MPNs
    [sensor_board_v0.53.brd, sensor_board_v0.53.sch]
2017-03-01 BOM update
    [sensor_board_v0.53.brd, sensor_board_v0.53.sch]
2017-03-01 Updated SHT31/35 library
    Replaced old library with Adafruit version - slightly longer pads to avoid potential bridging during reflow.
    [sensor_board_v0.53.brd, sensor_board_v0.53.sch]
2017-03-01 Updated BOM
    [sensor_board_v0.53.brd, sensor_board_v0.53.sch]
2017-03-08 v0.53 - update
    - Aligned light sensor with RGB LED
    - Moved jumpers location after moving light sensor
    - Added PM2.5 jumpers (RX/TX/PWR/GND)
    - Adjusted some passive components
    - Several trace adjustments
    - Slightly increased board dimensions for added tolerance on mounting
    holes
    [sensor_board_v0.53.brd, sensor_board_v0.53.sch]
2017-03-08 v0.53 - update
    - (previous commit: Replaced 10-pin header with 6-pin ISP header)
    - This commit: Added 1K resistors in series with FTDI's RX/TX line to
    give priority to external serial devices (unplug external device to
    program the board)
    - Some trace/silkscreen adjustments
    [sensor_board_v0.53.brd, sensor_board_v0.53.sch]
2017-03-08 Fixed attributes
    Updated MPN for 1K ohm resistor
    [sensor_board_v0.53.brd, sensor_board_v0.53.sch]
2017-03-08 Via and keepout adjustments
    and silkscreen adjustments
    [sensor_board_v0.53.brd]
2017-03-22 v0.54 - major bug fixes
    - SCK trace was grounding PWR, GND, RX, TX in v0.53 (bruh) - this is
    fixed now
    - MOSI trace was being grounded by one GND via (bruuh) - this is also
    fixed now
    - Accounted for OSH park's DRC warnings (except drill size - works for
    now)
    - Replaced 1uF cap with 0.uF and 10uF cap on VCC out from voltage
    regulator for extra noise filtering
    - Some trace adjustments
    - Some silkscreen adjustments
    [sensor_board_v0.54.brd, sensor_board_v0.54.sch]
2017-03-22 BOM update
    - Added MPN for 0.1 and 10uF
    - Added I2C address and value for SHT35 on schematic
    [sensor_board_v0.54.brd, sensor_board_v0.54.sch]
2017-03-28 Added v0.54 firmware
    - support for TSL2591 sensor
    - support for NeoPixel
2017-03-29 adding bom for .54
    [sensor_board_v0.54_BOM.csv]
2017-03-30 v0.55 - Trace antenna
    - Changed RFM69HW to RFM69HCW (smaller + better antenna pad placement)
    - Changed board dimensions to be a square (56.4mm)
    - Added a simple printed circuit whip (stub) trace antenna following
    this guide: http://www.hoperf.com/upload/rf/ANTENNAS_MODULE.pdf
    - Adjusted some traces to accomodate for new radio
    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
    [sensor_board_v0.55.brd, sensor_board_v0.55.csv, sensor_board_v0.55.sch]
2017-03-31 v0.54 update - resonator library changed
    - Replaced previous resonator library (thinner pads, incorrectly
    aligned, usually got lucky) with one that has fatter pads (from RFM69
    USB gateway)
    [sensor_board_v0.54.brd, sensor_board_v0.54.sch]
2017-04-05 v0.55 - Major design update
    - Added 2x5 header for PMS7003 PM sensor
    - Moved microphone+amp circuitry to accomodate for the PM sensor header
    - Removed UART and software serial breakout headers
    - Moved voltage regulator circuitry in space created by removing UART
    header
    - Moved LED in space created by moving voltage regulator
    - Moved light sensor to be in line with LED
    - Rerouted several traces to accomodate for new design
    - Provided some more tolerance to the mounting holes
    - Moved fiducial markers
    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
    [sensor_board_v0.55.brd, sensor_board_v0.55.csv, sensor_board_v0.55.sch]
2017-04-05 Renamed folder
    experimental trace antenna in its own folder
    [sensor_board_v0.55_trace.brd, sensor_board_v0.55_trace.sch]
2017-04-05 Rename version number
    - Experimental trace antenna actually modification of v0.54
    [sensor_board_v0.54_trace.brd, sensor_board_v0.54_trace.sch]
2017-04-11 v0.55 - major update 2
    - Added 915MHz chip antenna (JT 0868AT43A0020E) using ref. designs from:
    https://www.johansontechnology.com/datasheets/antennas/0868AT43A0020.pdf
    and http://www.ti.com/lit/an/swra160b/swra160b.pdf
    - Replaced RFM69HW with RFM69HCW to accomodate for space for chip
    antenna
    - Rerouted traces to accomodate for new parts
    - Minor adjustments to board dimensions (slight increase along Y axis)
    - Other minor adjustments to traces, vias, silkscreen
    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
    [sensor_board_v0.55.brd, sensor_board_v0.55.sch]
2017-04-17 Shifted IAQ core lower
    So it aligns with the Radio a bit more. Rerouted some traces and
    rearranged the decoupling cap
    [sensor_board_v0.55.brd]
2017-04-17 Added trace for wire monopole antenna
    - wire antenna can be used by means of a jumper (in the event that chip
    antenna doesn't work - make sure to desolder the chip antenna +
    components)
    - not sure of performance of chip + wire antenna trace (with
    disconnected jumper) - maybe the trace adds capacitance or random noise?
    [sensor_board_v0.55.brd, sensor_board_v0.55.sch]
2017-04-17 Redesigned antenna trace
    - Removed trace for wire monopole (it needs GND plane underneath, so
    wouldn't have worked anyway)
    - Added jumper for SMD feed (if chip doesn't work, remove jumper, solder
    wire monopole directly to radio ANT pad
    [sensor_board_v0.55.brd, sensor_board_v0.55.sch]
2017-05-08 Increased pin hole diameter for PM2.5 sensor
    [sensor_board_v0.55.brd, sensor_board_v0.55.sch]
2017-05-08 Silkscreen updates
    [sensor_board_v0.55.brd, sensor_board_v0.55.sch]
2017-05-12 add submodules for IEQ arduino libraries
2017-06-17 Added v0.56 EAGLE files
    Traces still incomplete
    [sensor_board_v0.56.brd, sensor_board_v0.56.sch]
2017-06-20 Rearranged old files
    [sensor_board_BOM.csv, sensor_board_v0.5.brd, sensor_board_v0.5.sch, sensor_board_v0.51.brd, sensor_board_v0.51.sch, sensor_board_v0.52.brd, sensor_board_v0.52.sch, sensor_board_v0.53.brd]
2017-06-20 Added Power Booster circuit; a lot of rearrangments
    circuit traces still incomplete
    [sensor_board_v0.56.brd, sensor_board_v0.56.sch]
2017-06-22 Added notches in the board
    [sensor_board_v0.56.brd, sensor_board_v0.56.sch]
2017-06-23 v0.56 - completed
    DRC & ERC checked
    Features:
    - Board dimensions and component placement completely redesigned
    - Neopixel Mini replaced by NeoPixel Nano 2427
    - Light pipes for NeoPixel and Light sensor
    - SHT31 replaced with Si7021
    - Added three mounting holes
    - Cutout for the helical antenna
    - CCS811 VOC sensor added
    - MH-z19 CO2 sensor pads added (can be replaced with IAQ core - pads
    also available) (can also be replaced by S8 CO2 sensor in future for
    larger orders)
    - ATMEGA328P-AU replaced by ATMEGA328P-MU (QFN)
    - FT232RL replaced by FT231XQ (QFN)
    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
    [sensor_board_v0.56.brd, sensor_board_v0.56_b.brd, sensor_board_v0.56_b.sch]
2017-06-24 hiding layers
    [sensor_board_v0.56.brd]
2017-06-26 Trace and silkscreen adjustments
    [sensor_board_v0.56.brd]
2017-06-29 Added another decoupling cap to ATMega328P
    [sensor_board_v0.56.brd, sensor_board_v0.56.sch]
2017-07-11 Firmware updated for v0.56 board
2017-07-11 v0.56b - minor adjustments
    - Rerouted D9 trace to be SET pin for PM sensor instead of PWM pin for
    CO2 sensor
    - Added 10K pull up on D9
    - Moved components away from light sensor and RGB LED's light pipe's
    path
    - Added extra vias all around for more ground stitching
    [sensor_board_v0.56.brd, sensor_board_v0.56.sch]
2017-07-17 v0.56b - minor update
    - Moved CO2 sensor up the board
    - Updated library for light pipe
    - Adjusted components around the light pipe
    - Some silkscreen and trace adjustments
    [sensor_board_v0.56.brd, sensor_board_v0.56.sch]
2017-07-17 Updated v0.56b with SMD pads for MH-z19 sensor
    - other minor trace, parts and silkscreen adjustments
    [sensor_board_v0.56.brd, sensor_board_v0.56.sch]
2017-07-17 v0.56b - minor update
    silkscreen update and a couple of traces
    [sensor_board_v0.56.brd, sensor_board_v0.56.sch]
2017-07-17 Shifted radio a bit
    to allow space for the light pipe to land
    [sensor_board_v0.56.brd]
2017-07-20 Changed call to initialize CCS811 sensor in setup
    it was being constantly polled in loop - probably resetting readings
    every time
    [firmware.ino]
